BMellor/noisy_cricket_sao/hardware/noisy_cricket_sao.kicad_sch

## KiCad design hardware/noisy_cricket_sao.kicad_sch (2026-11-07)

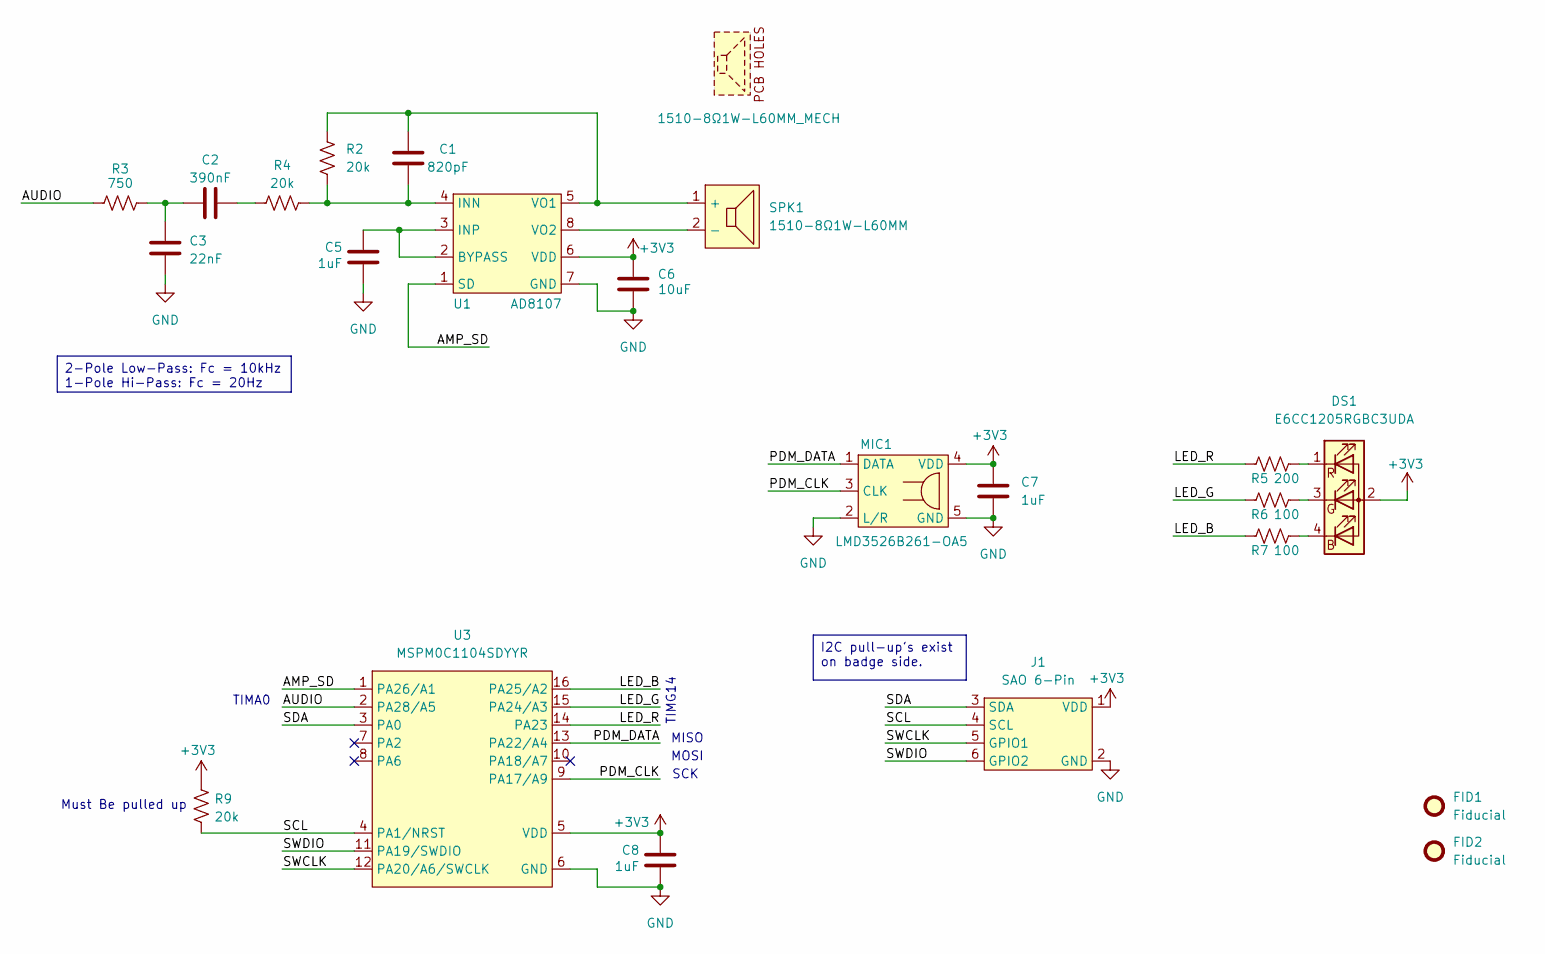
[picture p1: schematic noisy_cricket_sao.kicad_sch]

Parts:
C1: 820pF; C_0402_1005Metric
C2: 390nF; C_0402_1005Metric
C3: 22nF; C_0402_1005Metric
C5, C7, C8: 1uF; C_0402_1005Metric
C6: 10uF; C_0603_1608Metric
DS1: E6CC1205RGBC3UDA
FID1, FID2: Fiducial; Fiducial_0.5mm_Mask1.5mm
J1: SAO 6-Pin; PinHeader_2x03_P2.54mm_Vertical_SMD
MECH1: 1510-8Ω1W-L60MM_MECH
MIC1: LMD3526B261-OA5
R2, R4, R9: 20k; R_0402_1005Metric
R3: 750; R_0402_1005Metric
R5: 200; R_0402_1005Metric
R6, R7: 100; R_0402_1005Metric
SPK1: 1510-8Ω1W-L60MM; 1510-8Ω1W-L60MM_SMT_PADS
U1: AD8107
U3: MSPM0C1104SDYYR; SOT23-16-TI

Connections:
+3V3: C6.1, C7.2, C8.2, DS1.2 (A), J1.1 (VDD), MIC1.4 (VDD), R9.1, U1.6 (VDD), U3.5 (VDD)
AMP_SD: U1.1 (SD), U3.1 (PA26/A1)
AUDIO: R3.1, U3.2 (PA28/A5)
GND: C3.2, C5.1, C6.2, C7.1, C8.1, J1.2 (GND), MIC1.2 (L/R), MIC1.5 (GND), U1.7 (GND), U1.9 (EP), U3.6 (GND)
LED_B: R7.1, U3.16 (PA25/A2)
LED_G: R6.1, U3.15 (PA24/A3)
LED_R: R5.1, U3.14 (PA23)
unnamed: C1.1, R2.2, SPK1.1 (+), U1.5 (VO1)
unnamed: C1.2, R2.1, R4.2, U1.4 (INN)
unnamed: C2.1, C3.1, R3.2
unnamed: C2.2, R4.1
unnamed: C5.2, U1.2 (BYPASS), U1.3 (INP)
unnamed: DS1.1 (RK), R5.2
unnamed: DS1.3 (GK), R6.2
unnamed: DS1.4 (BK), R7.2
unnamed: SPK1.2 (-), U1.8 (VO2)
PDM_CLK: MIC1.3 (CLK), U3.9 (PA17/A9)
PDM_DATA: MIC1.1 (DATA), U3.13 (PA22/A4)
SCL: J1.4 (SCL), R9.2, U3.4 (PA1/NRST)
SDA: J1.3 (SDA), U3.3 (PA0)
SWCLK: J1.5 (GPIO1), U3.12 (PA20/A6/SWCLK)
SWDIO: J1.6 (GPIO2), U3.11 (PA19/SWDIO)

Notes on the sheet:
TIMG14
MISO
Must Be pulled up
TIMA0
SCK
MOSI
2-Pole Low-Pass: Fc = 10kHz 1-Pole Hi-Pass: Fc = 20Hz
I2C pull-up's exist on badge side.
