BMellor/noisy_cricket_sao/firmware/src/chirp_lut.h

/* 650-sample chirp at 23437.5 Hz (27.7 ms), 8-bit unsigned PWM values centred on 128.
 * Same layout as matlab/gen_chirp_lut.m output, so a regenerated chirp_lut.h can replace this file. */
#include <stdint.h>

#define CHIRP_FS_HZ 23437.5000
#define CHIRP_LEN 650

static const uint8_t chirp_lut[CHIRP_LEN] = {
    119, 126, 128, 122, 117, 118, 122, 134, 129, 115, 111, 119, 130, 133, 124, 110, 111, 126, 133, 129, 115, 107, 122,
    135, 135, 122, 107, 116, 128, 136, 129, 111, 109, 116, 138, 136, 116, 100, 110, 130, 144, 130, 103, 104, 122, 141,
    140, 115, 98,  108, 134, 144, 125, 102, 101, 125, 144, 140, 112, 98,  111, 138, 150, 127, 95,  95,  127, 151, 142,
    108, 92,  107, 141, 154, 128, 93,  94,  129, 154, 141, 104, 88,  107, 147, 154, 128, 94,  96,  129, 160, 141, 104,
    84,  106, 153, 160, 125, 87,  93,  133, 165, 145, 103, 80,  110, 154, 160, 121, 84,  87,  135, 170, 149, 97,  77,
    107, 161, 162, 119, 80,  87,  140, 171, 147, 91,  76,  111, 164, 167, 120, 70,  84,  143, 180, 149, 84,  64,  110,
    171, 171, 116, 64,  82,  148, 183, 150, 78,  65,  117, 174, 171, 112, 59,  83,  155, 187, 148, 75,  56,  119, 181,
    177, 110, 54,  82,  158, 192, 149, 67,  54,  120, 188, 179, 99,  46,  81,  165, 200, 141, 64,  55,  125, 192, 175,
    94,  44,  83,  170, 201, 136, 58,  52,  129, 203, 176, 91,  37,  87,  180, 200, 130, 46,  50,  141, 209, 172, 81,
    36,  95,  186, 201, 125, 40,  54,  148, 213, 171, 71,  34,  96,  196, 206, 116, 36,  57,  155, 215, 165, 62,  31,
    105, 201, 205, 112, 31,  61,  161, 216, 162, 59,  29,  116, 208, 197, 102, 23,  68,  172, 217, 152, 47,  31,  122,
    213, 195, 92,  21,  68,  178, 219, 143, 39,  34,  129, 218, 195, 83,  19,  77,  189, 222, 137, 33,  35,  140, 222,
    190, 78,  19,  82,  194, 218, 130, 30,  39,  142, 226, 188, 70,  18,  89,  200, 222, 125, 26,  38,  152, 232, 182,
    65,  16,  92,  206, 220, 120, 18,  41,  156, 232, 178, 57,  13,  96,  210, 219, 115, 18,  42,  162, 236, 177, 52,
    13,  96,  212, 224, 113, 15,  44,  166, 234, 174, 55,  13,  100, 212, 218, 107, 16,  45,  165, 236, 173, 50,  10,
    99,  214, 222, 109, 14,  47,  170, 235, 171, 53,  14,  104, 213, 221, 113, 15,  45,  162, 232, 177, 52,  13,  102,
    213, 219, 114, 14,  42,  163, 230, 176, 59,  11,  97,  211, 221, 117, 23,  39,  152, 230, 181, 62,  11,  89,  203,
    219, 123, 26,  35,  148, 224, 184, 69,  16,  86,  195, 220, 132, 32,  37,  137, 223, 190, 78,  18,  79,  189, 224,
    144, 41,  37,  122, 215, 199, 96,  22,  65,  171, 218, 153, 52,  29,  113, 205, 202, 109, 32,  54,  157, 216, 165,
    67,  28,  98,  194, 208, 125, 44,  49,  140, 208, 178, 84,  35,  82,  173, 205, 146, 57,  46,  122, 198, 190, 106,
    43,  70,  156, 200, 158, 76,  44,  104, 180, 190, 128, 56,  59,  132, 192, 174, 96,  53,  85,  161, 192, 146, 74,
    59,  114, 178, 177, 117, 64,  71,  138, 181, 162, 98,  61,  94,  157, 179, 141, 82,  67,  112, 173, 171, 118, 71,
    79,  129, 176, 156, 103, 72,  91,  146, 169, 141, 86,  73,  108, 160, 169, 125, 80,  81,  124, 164, 157, 113, 83,
    90,  134, 161, 148, 100, 80,  99,  148, 162, 136, 92,  84,  115, 153, 159, 126, 89,  86,  121, 157, 157, 116, 91,
    100, 133, 153, 142, 109, 91,  104, 138, 153, 139, 104, 91,  108, 142, 151, 131, 101, 93,  116, 145, 146, 125, 99,
    98,  121, 146, 145, 121, 97,  100, 127, 144, 141, 117, 99,  104, 129, 145, 139, 113, 98,  107, 133, 146, 136, 110,
    98,  110, 136, 146, 132, 107, 98,  114, 139, 145, 129, 108, 104, 118, 137, 139, 126, 106, 106, 120, 140, 137, 126,
    108, 113, 122, 136, 130, 118, 108, 115, 128, 136, 129, 116, 108, 117, 129, 136, 127, 115, 108, 119, 131, 135, 126,
    113, 112, 123, 127, 128, 122};
